mwelling/orangecrab-test/README.md

# orangecrab-test
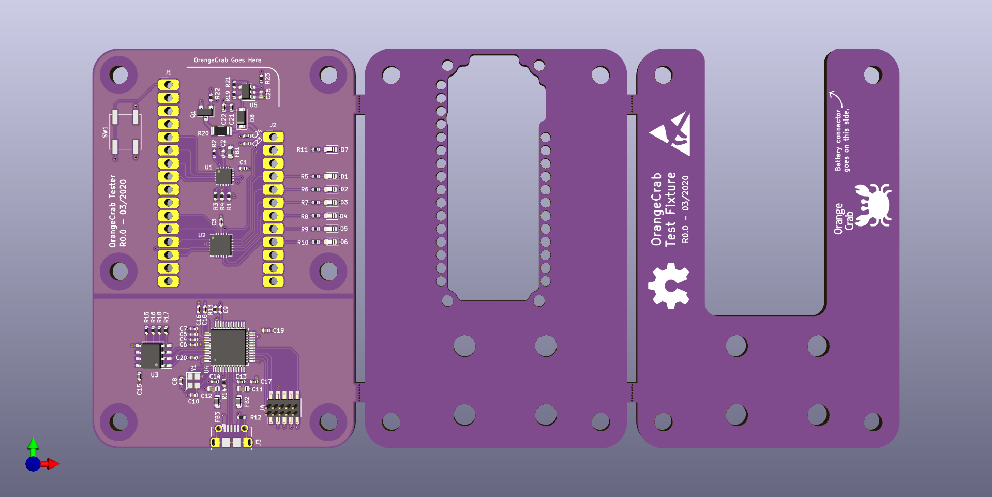
[picture p1: orangecrab-test.png]


Assembled view:
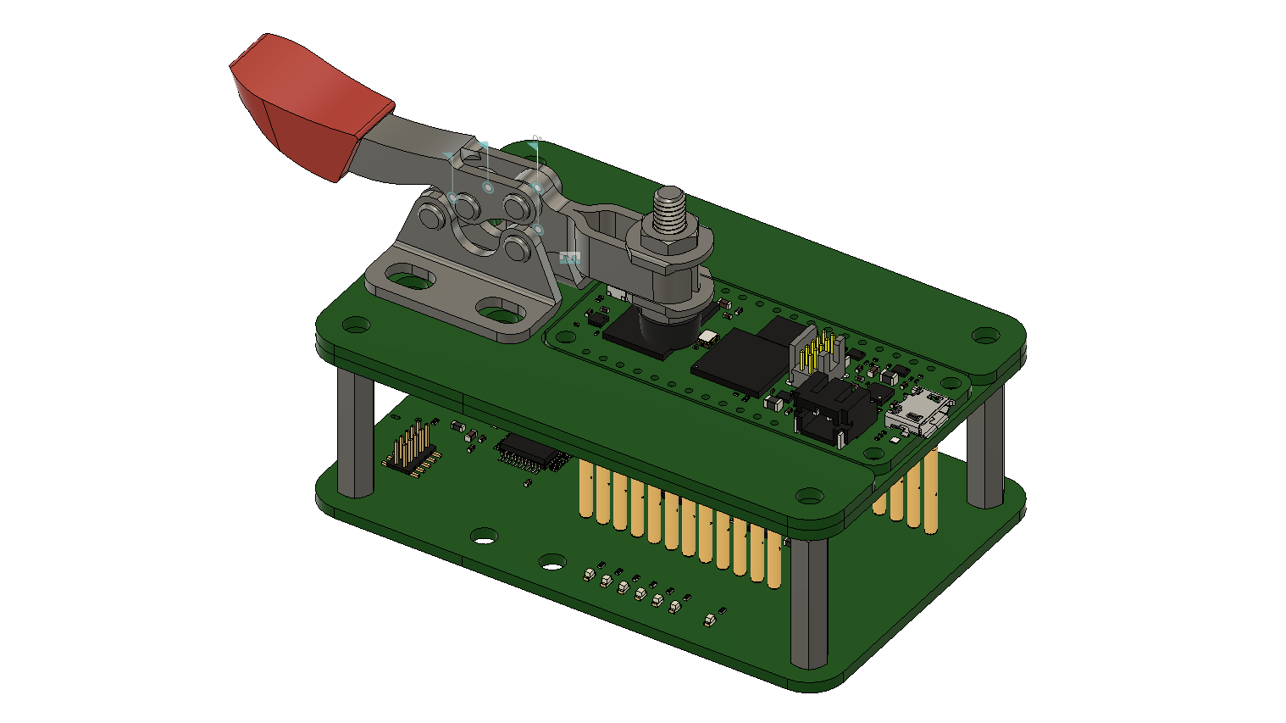
[picture p2: orangecrab-test-assembled.png]
