mwelling/orangecrab-test/orangecrab-test.pdf

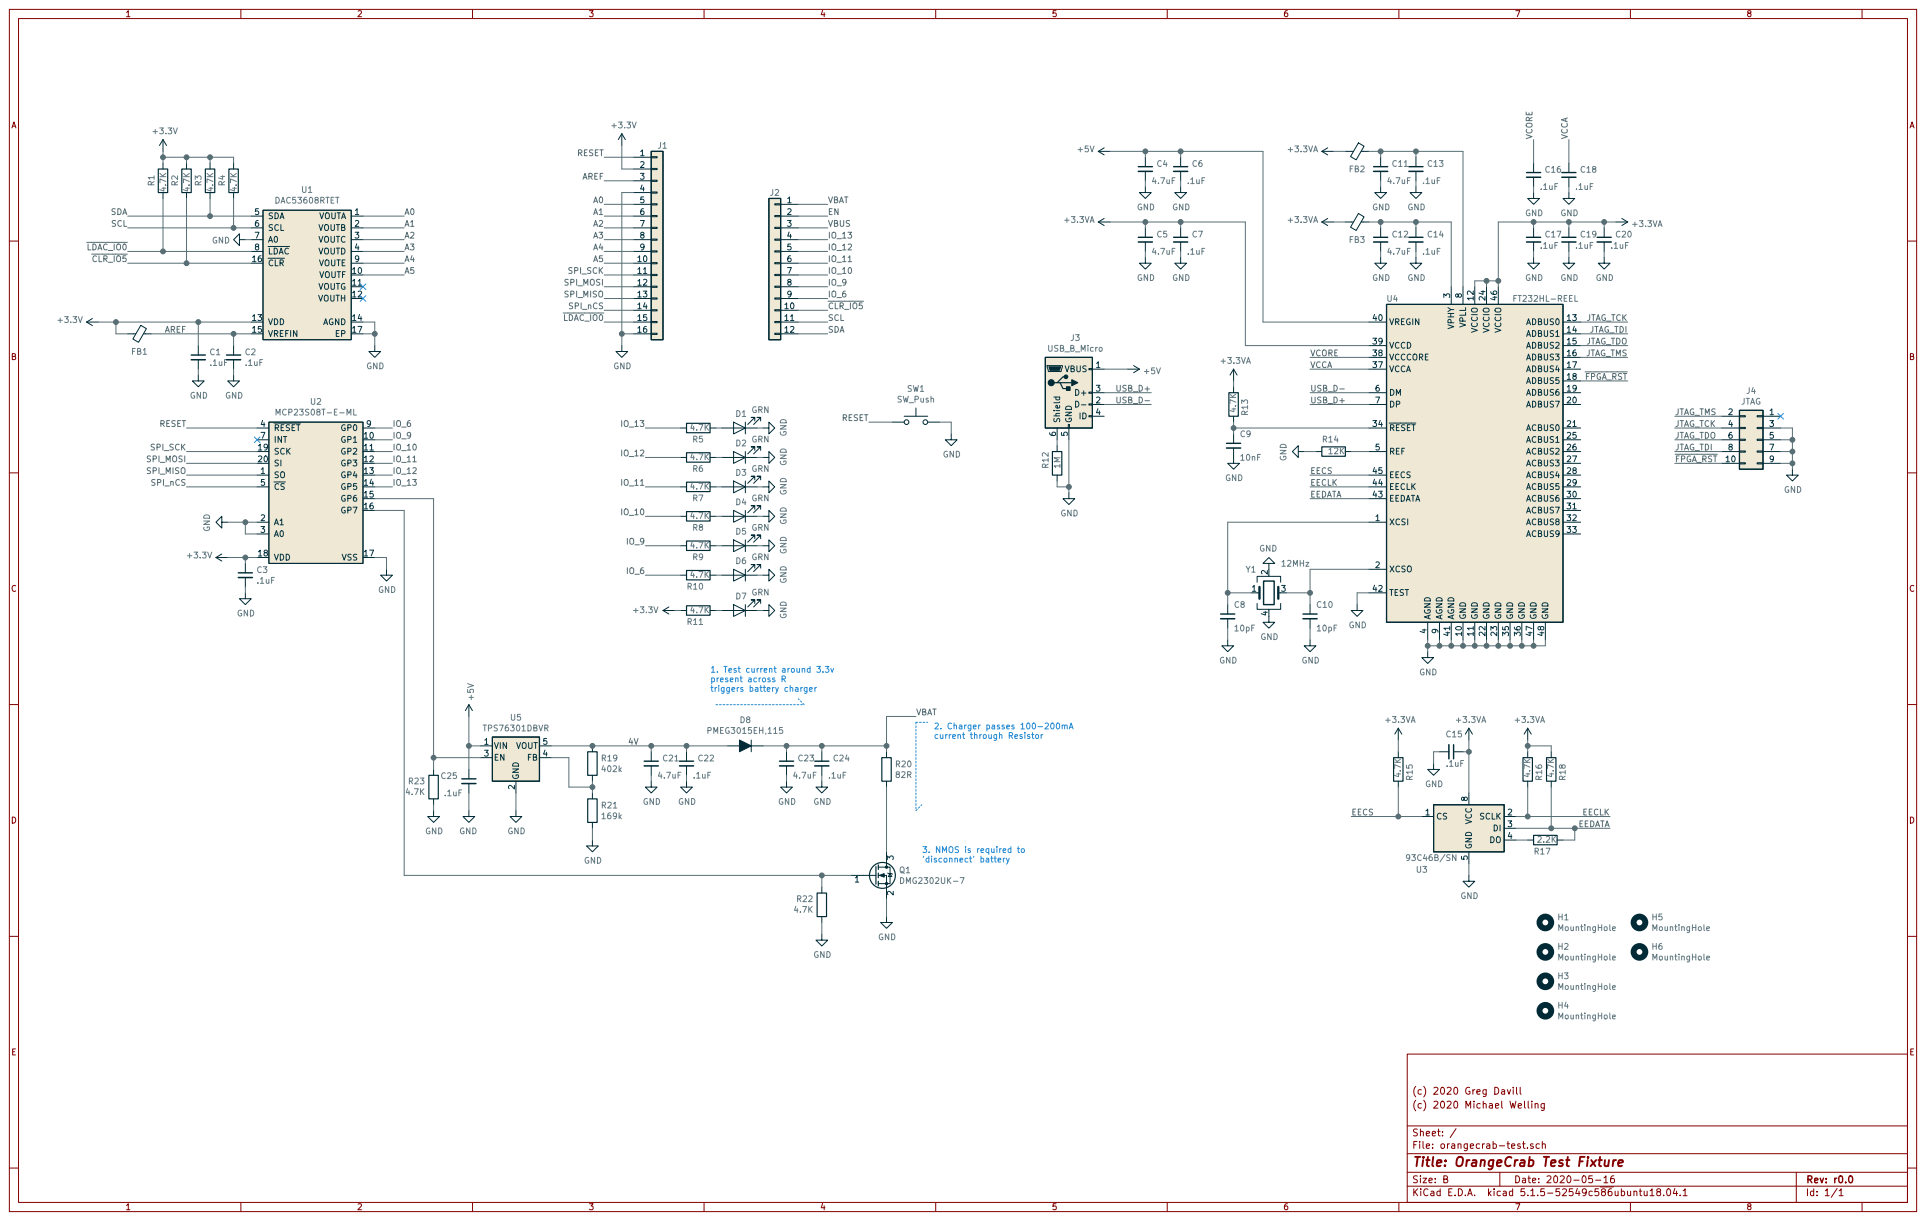
[picture p3: page 1]

4 VREGIN 40 AGND 41 TEST 42 EEDATA 43 EECLK 44 EECS 45 VCCIO 46 GND 47 GND 48 REF 5 DM 6 DP 7 VPLL
(c) 2020 Greg Davill GND

3 ACBUS6 30 ACBUS7 31 ACBUS8 32 ACBUS9 33 RESET 34 GND 35 GND 36 VCCA 37 VCCCORE 38 VCCD 39 AGND

1. Test current around 3.3v present across R

3. NMOS is required to
'disconnect' battery

File: orangecrab-test.sch Sheet: / (c) 2020 Michael Welling

Id: 1/1 Title: OrangeCrab Test Fixture
