mwelling/orangecrab-test/orangecrab-test.sch

## KiCad design orangecrab-test.sch (2020-05-18)

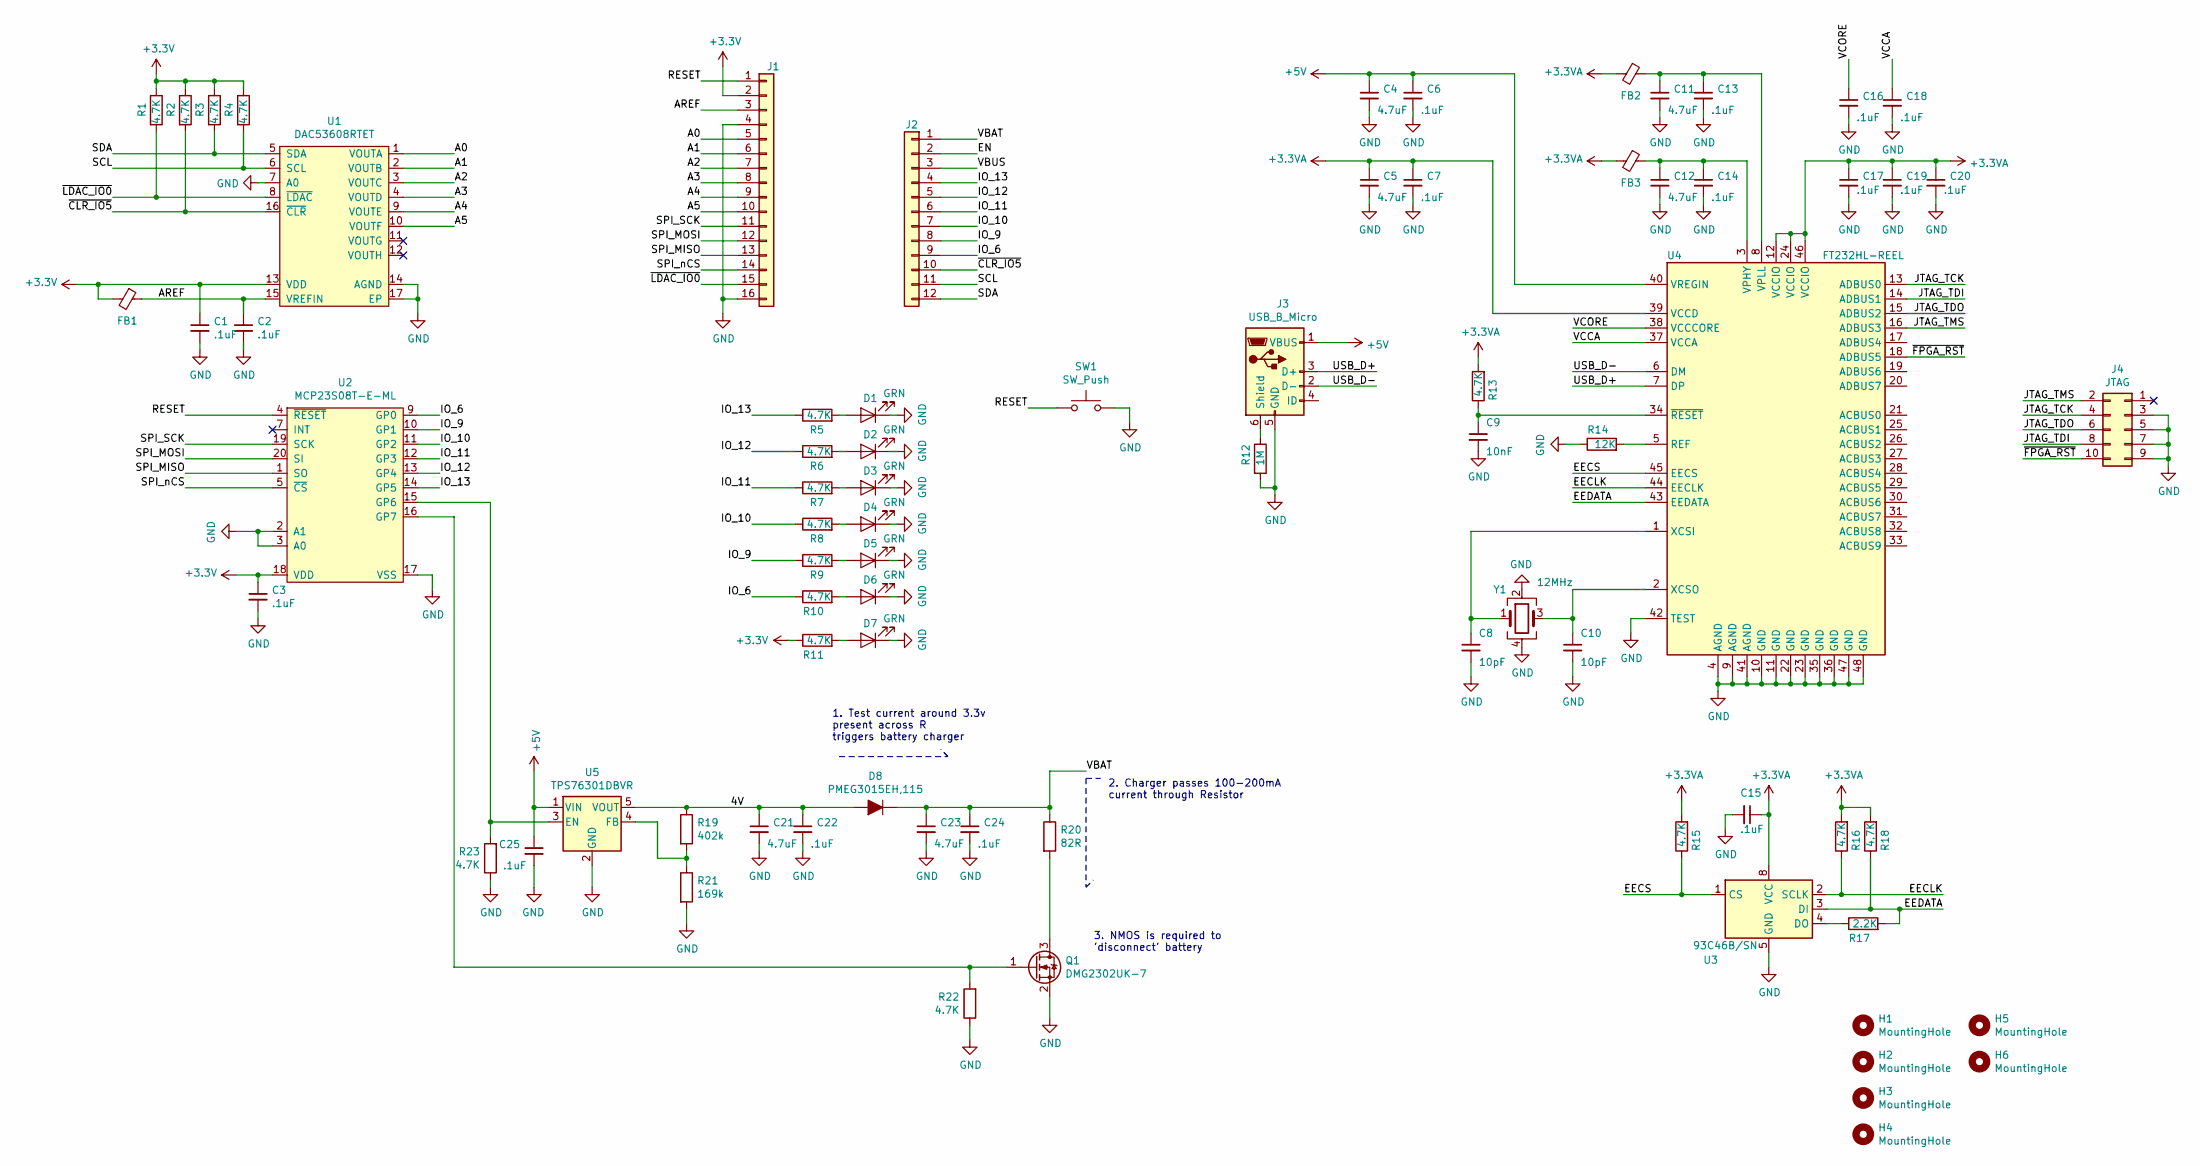
[picture p4: schematic orangecrab-test.sch]

Parts:
C1, C2, C3, C6, C7, C13, C14, C15, C16, C17, C18, C19, C20, C22, C24, C25: .1uF; C_0402_1005Metric; MPN GRM155R71C104KA88J
C4, C5, C21, C23: 4.7uF; C_0402_1005Metric; MPN GRM155R60J475ME47D
C8, C10: 10pF; C_0402_1005Metric; MPN GRM1555C1H100JA01D
C9: 10nF; C_0402_1005Metric; MPN C0402C103K4RECAUTO
C11, C12: 4.7uF; C_0603_1608Metric; MPN C0603C475K9PACTU
D1, D2, D3, D4, D5, D6, D7: GRN; LED_0603_1608Metric; MPN LTST-C191GKT
D8: PMEG3015EH,115; D_SOD-123F; MPN PMEG3015EH,115
FB1, FB2, FB3: Ferrite_Bead_Small; L_0603_1608Metric; MPN 742792651
H1, H2, H3, H4, H5, H6: MountingHole; MountingHole_3.5mm; MPN N/A
J1: Conn_01x16; PinHeader_1x16_P2.54mm_Vertical; MPN N/A
J2: Conn_01x12; PinHeader_1x12_P2.54mm_Vertical; MPN N/A
J3: USB_B_Micro; USB_Micro-B_Molex-105017-0001; MPN 1050170001
J4: JTAG; PinHeader_2x05_P1.27mm_Vertical_SMD; MPN FTSH-105-01-F-DV-K-TR
Q1: DMG2302UK-7; SOT-23; MPN DMG2302UK-7
R1, R2, R3, R4, R5, R6, R7, R8, R9, R10, R11, R13, R15, R16, R18, R22, R23: 4.7K; R_0402_1005Metric; MPN RC0402JR-074K7L
R12: 1M; R_0402_1005Metric; MPN RC0402FR-071ML
R14: 12K; R_0402_1005Metric; MPN ERA-2AEB123X
R17: 2.2K; R_0402_1005Metric; MPN ERA-2AEB222X
R19: 402k; R_0402_1005Metric; MPN RMCF0402FT402K
R20: 82R; R_1206_3216Metric; MPN RC1206JR-0782RL
R21: 169k; R_0402_1005Metric; MPN RC0402FR-07169KL
SW1: SW_Push; SW_SPST_EVQP0; MPN EVQ-P0N02B
U1: DAC53608RTET; QFN-16-1EP_3x3mm_P0.5mm_EP1.8x1.8mm; MPN DAC53608RTET
U2: MCP23S08T-E-ML; QFN-20-1EP_4x4mm_P0.5mm_EP2.5x2.5mm; MPN MCP23S08T-E-ML
U3: 93C46B/SN; SOIC-8_3.9x4.9mm_P1.27mm; MPN 93C46B/SN
U4: FT232HL-REEL; TQFP-48-1EP_7x7mm_P0.5mm_EP5x5mm; MPN FT232HL-REEL
U5: TPS76301DBVR; SOT-23-5; MPN TPS76301DBVR
Y1: 12MHz; Crystal_SMD_2520-4Pin_2.5x2.0mm; MPN FA-20H 12.0000MD30Z-K3

Connections:
4V: C21.1, C22.1, D8.2 (A), R19.1, U5.5 (VOUT)
+3.3V: C1.1, C3.1, FB1.2, J1.2, R1.1, R2.1, R3.1, R4.1, R11.1, U1.13 (VDD), U2.18 (VDD)
+3.3VA: C5.1, C7.1, C15.1, C17.1, C19.1, C20.1, FB2.2, FB3.2, R13.2, R15.2, R16.2, R18.2, U3.8 (VCC), U4.12 (VCCIO), U4.24 (VCCIO), U4.39 (VCCD), U4.46 (VCCIO)
+5V: C4.1, C6.1, C25.1, J3.1 (VBUS), U4.40 (VREGIN), U5.1 (VIN)
A0: J1.5, U1.1 (VOUTA)
A1: J1.6, U1.2 (VOUTB)
A2: J1.7, U1.3 (VOUTC)
A3: J1.8, U1.4 (VOUTD)
A4: J1.9, U1.9 (VOUTE)
A5: J1.10, U1.10 (VOUTF)
AREF: C2.1, FB1.1, J1.3, U1.15 (VREFIN)
EECLK: R16.1, U3.2 (SCLK), U4.44 (EECLK)
EECS: R15.1, U3.1 (CS), U4.45 (EECS)
EEDATA: R17.2, R18.1, U3.3 (DI), U4.43 (EEDATA)
EN: J2.2
GND: C1.2, C2.2, C3.2, C4.2, C5.2, C6.2, C7.2, C8.2, C9.2, C10.2, C11.2, C12.2, C13.2, C14.2, C15.2, C16.2, C17.2, C18.2, C19.2, C20.2, C21.2, C22.2, C23.2, C24.2, C25.2, D1.1 (K), D2.1 (K), D3.1 (K), D4.1 (K), D5.1 (K), D6.1 (K), D7.1 (K), J1.4, J1.16, J3.5 (GND), J4.3, J4.5, J4.7, J4.9, Q1.2 (S), R12.2, R14.1, R21.2, R22.1, R23.1, SW1.2, U1.7 (A0), U1.14 (AGND), U1.17 (EP), U2.2 (A1), U2.3 (A0), U2.17 (VSS), U3.5 (GND), U4.4 (AGND), U4.9 (AGND), U4.10 (GND), U4.11 (GND), U4.22 (GND), U4.23 (GND), U4.35 (GND), U4.36 (GND), U4.41 (AGND), U4.42 (TEST), U4.47 (GND), U4.48 (GND), U5.2 (GND), Y1.2, Y1.4
IO_6: J2.9, R10.1, U2.9 (GP0)
IO_9: J2.8, R9.1, U2.10 (GP1)
IO_10: J2.7, R8.1, U2.11 (GP2)
IO_11: J2.6, R7.1, U2.12 (GP3)
IO_12: J2.5, R6.1, U2.13 (GP4)
IO_13: J2.4, R5.1, U2.14 (GP5)
JTAG_TCK: J4.4, U4.13 (ADBUS0)
JTAG_TDI: J4.8, U4.14 (ADBUS1)
JTAG_TDO: J4.6, U4.15 (ADBUS2)
JTAG_TMS: J4.2, U4.16 (ADBUS3)
unnamed: C8.1, U4.1 (XCSI), Y1.1
unnamed: C9.1, R13.1, U4.34 (~RESET)
unnamed: C10.1, U4.2 (XCSO), Y1.3
unnamed: C11.1, C13.1, FB2.1, U4.8 (VPLL)
unnamed: C12.1, C14.1, FB3.1, U4.3 (VPHY)
unnamed: D1.2 (A), R5.2
unnamed: D2.2 (A), R6.2
unnamed: D3.2 (A), R7.2
unnamed: D4.2 (A), R8.2
unnamed: D5.2 (A), R9.2
unnamed: D6.2 (A), R10.2
unnamed: D7.2 (A), R11.2
unnamed: J3.6 (Shield), R12.1
unnamed: Q1.1 (G), R22.2, U2.16 (GP7)
unnamed: Q1.3 (D), R20.2
unnamed: R14.2, U4.5 (REF)
unnamed: R17.1, U3.4 (DO)
unnamed: R19.2, R21.1, U5.4 (FB)
unnamed: R23.2, U2.15 (GP6), U5.3 (EN)
RESET: J1.1, SW1.1, U2.4 (~RESET)
SCL: J2.11, R4.2, U1.6 (SCL)
SDA: J2.12, R3.2, U1.5 (SDA)
SPI_MISO: J1.13, U2.1 (SO)
SPI_MOSI: J1.12, U2.20 (SI)
SPI_SCK: J1.11, U2.19 (SCK)
SPI_nCS: J1.14, U2.5 (~CS)
USB_D+: J3.3 (D+), U4.7 (DP)
USB_D-: J3.2 (D-), U4.6 (DM)
VBAT: C23.1, C24.1, D8.1 (K), J2.1, R20.1
VBUS: J2.3
VCCA: C18.1, U4.37 (VCCA)
VCORE: C16.1, U4.38 (VCCCORE)
~CLR_IO5: J2.10, R2.2, U1.16 (~CLR)
~FPGA_RST: J4.10, U4.18 (ADBUS5)
~LDAC_IO0: J1.15, R1.2, U1.8 (~LDAC)

Notes on the sheet:
1. Test current around 3.3v present across R triggers battery charger
2. Charger passes 100-200mA current through Resistor
3. NMOS is required to 'disconnect' battery
