mwelling/orangecrab-test/(commit log)

2020-05-01 Add KiCAD files for design
    [orangecrab-test.kicad_pcb, orangecrab-test.sch]
2020-05-04 Add FTDI from programming the initial firmware
    [orangecrab-test.kicad_pcb, orangecrab-test.sch]
2020-05-10 Route board
    Consider making the FTDI a snap off section.
    [orangecrab-test.kicad_pcb, orangecrab-test.sch]
2020-05-10 Add a few more mounting holes
    [orangecrab-test.kicad_pcb, orangecrab-test.sch]
2020-05-12 added 2 layers for board/pogo alignment. battery circuit
    [orangecrab-test.kicad_pcb, orangecrab-test.sch]
2020-05-15 Add regulator input pulldown and add silkscreen bling
    [orangecrab-test.kicad_pcb, orangecrab-test.sch]
2020-05-15 Add BOM
    [orangecrab-test.csv, orangecrab-test.sch]
2020-05-16 r0.0 release: - Design review - Fixed minor error - Validate BOM - Generate and package gerbers for fabrication
    [orangecrab-test.csv, orangecrab-test.kicad_pcb, orangecrab-test.sch]
